do2mad/messsystem-1mhz/hardware/kicad/messystem.kicad_pcb

## KiCad design hardware/kicad/messystem.kicad_pcb (2026-10-09)

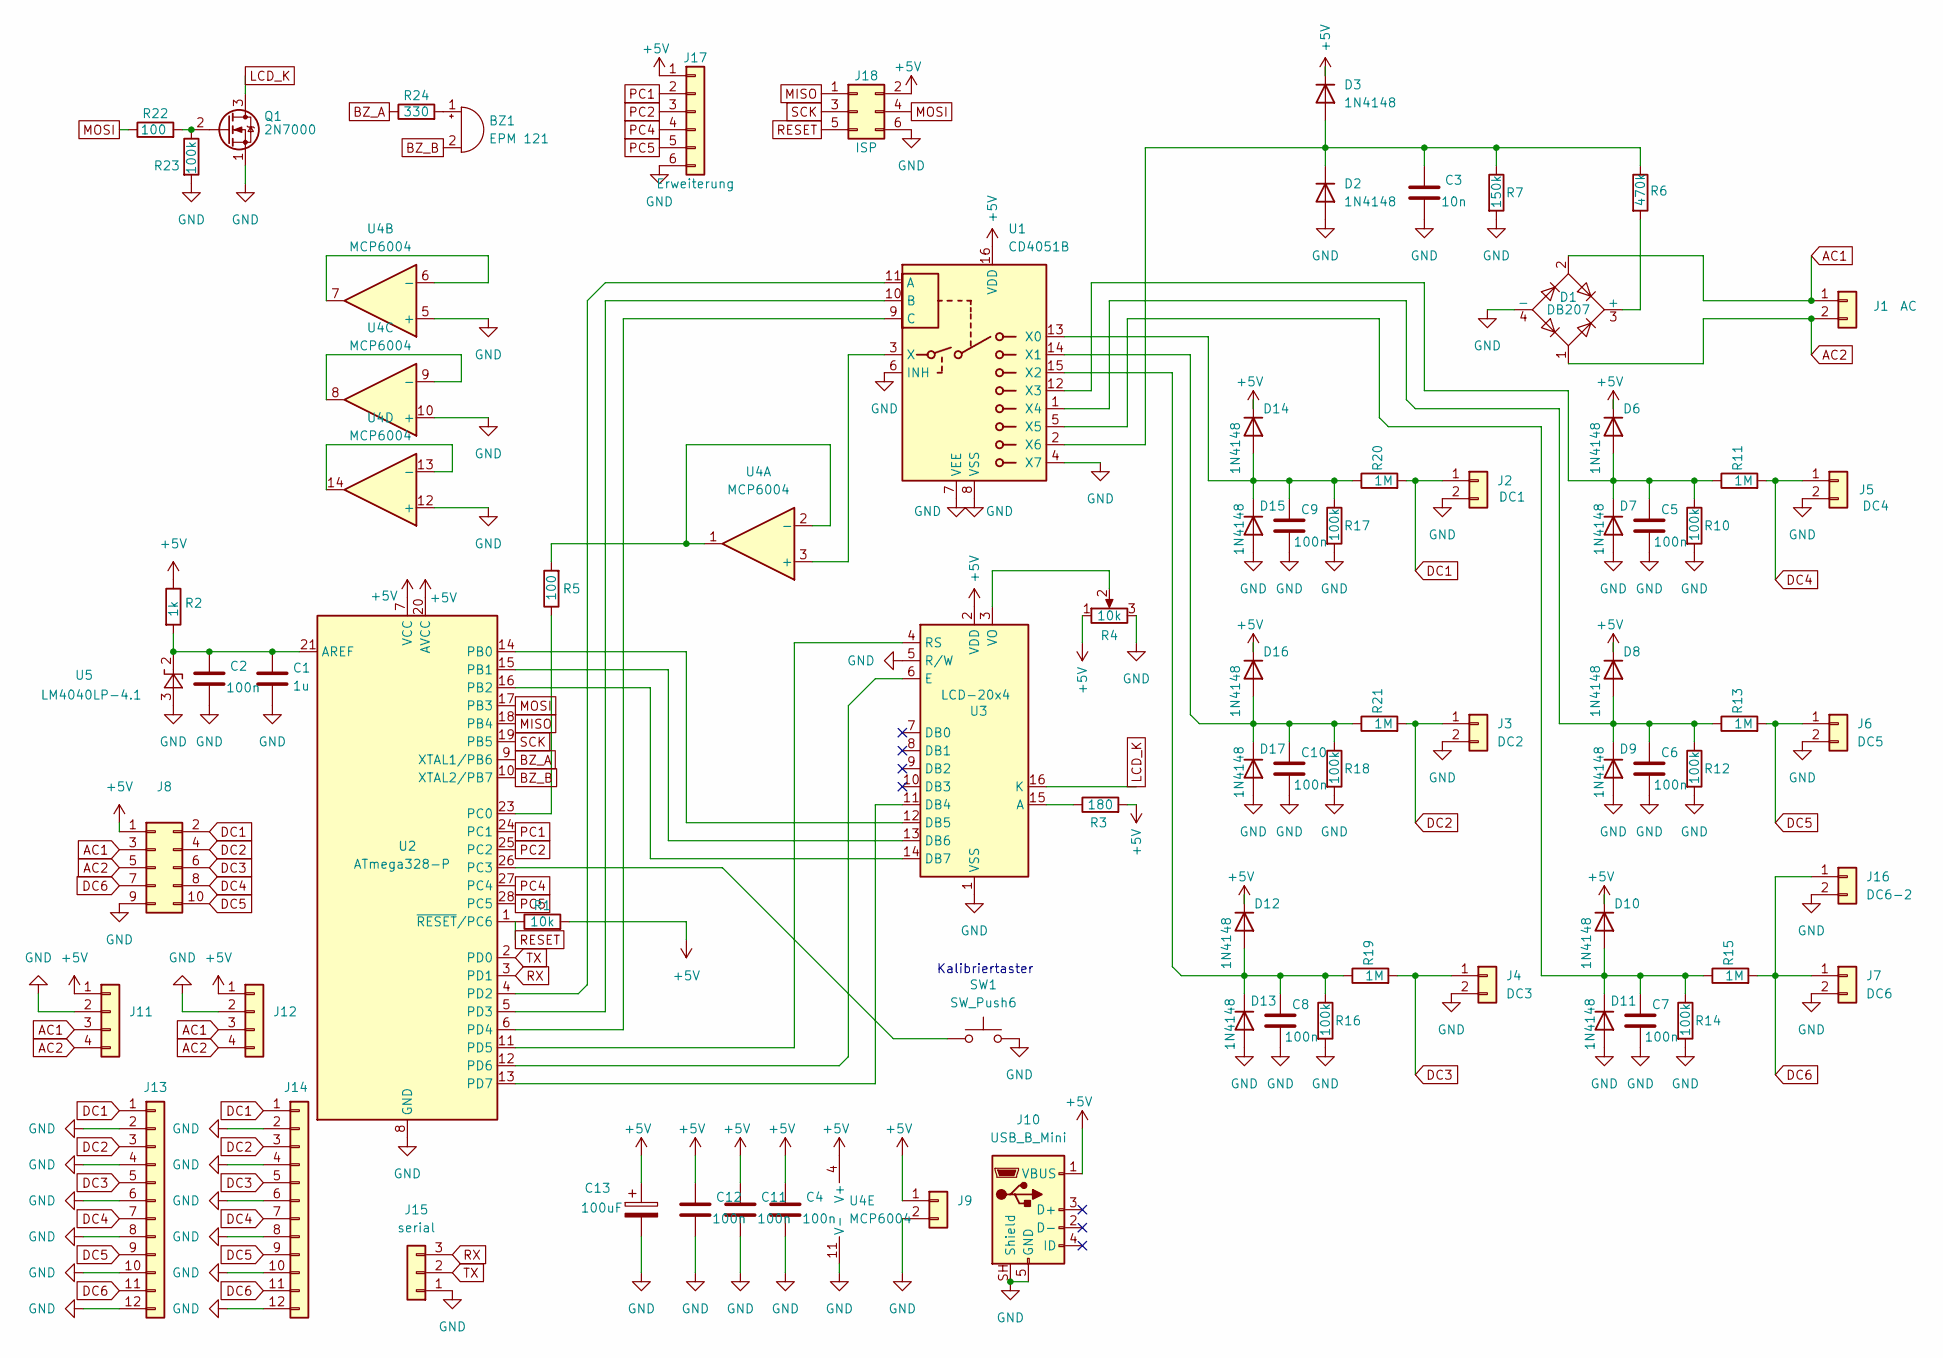
[picture p3: schematic messystem.kicad_sch]

Parts:
BZ1: EPM 121; Buzzer_12x9.5RM7.6
C1: 1u; C_MAD
C2, C4, C5, C6, C7, C8, C9, C10, C11, C12: 100n; C_MAD
C3: 10n; C_MAD
C13: 100uF; Elko_Mad
D1: DB207; Diode_Bridge_DIP-4_W7.62mm_P5.08mm
D2, D3, D6, D7, D8, D9, D10, D11, D12, D13, D14, D15, D16, D17: 1N4148; D_DO-35_SOD27_P7.62mm_Horizontal
J1: AC; PinHeader_1x02_P2.54mm_Vertical-MAD
J2: DC1; PinHeader_1x02_P2.54mm_Vertical-MAD
J3: DC2; PinHeader_1x02_P2.54mm_Vertical-MAD
J4: DC3; PinHeader_1x02_P2.54mm_Vertical-MAD
J5: DC4; PinHeader_1x02_P2.54mm_Vertical-MAD
J6: DC5; PinHeader_1x02_P2.54mm_Vertical-MAD
J7: DC6; PinHeader_1x02_P2.54mm_Vertical-MAD
J8: Conn_02x05_Odd_Even; IDC-Header_2x05_P2.54mm_Horizontal
J9: 5V; PinHeader_1x02_P2.54mm_Vertical-MAD
J10: USB_B_Mini; USB_Mini-B_horizontal
J11, J12: 5V/AC; PinSocket_1x04_P2.54mm_Vertical
J13, J14: DC1-DC6; PinSocket_1x12_P2.54mm_Vertical
J15: serial; PinSocket_1x03_P2.54mm_Vertical
J16: DC6-2; 2mm-banane
J17: Erweiterung; PinHeader_1x06_P2.54mm_Vertical
J18: ISP; PinHeader_2x03_P2.54mm_Vertical
Q1: 2N7000; TO-92_Inline
R1: 10k; R_Axial_DIN0204_L3.6mm_D1.6mm_P7.62mm_Horizontal
R2: 1k; R_Axial_DIN0204_L3.6mm_D1.6mm_P7.62mm_Horizontal
R3: 180; R_Axial_DIN0204_L3.6mm_D1.6mm_P7.62mm_Horizontal
R4: 10k; Potentiometer_Bourns_3296W_Vertical
R5, R22: 100; R_Axial_DIN0204_L3.6mm_D1.6mm_P7.62mm_Horizontal
R6: 470k; R_Axial_DIN0204_L3.6mm_D1.6mm_P7.62mm_Horizontal
R7: 150k; R_Axial_DIN0204_L3.6mm_D1.6mm_P7.62mm_Horizontal
R10, R12, R14, R16, R17, R18, R23: 100k; R_Axial_DIN0204_L3.6mm_D1.6mm_P7.62mm_Horizontal
R11, R13, R15, R19, R20, R21: 1M; R_Axial_DIN0204_L3.6mm_D1.6mm_P7.62mm_Horizontal
R24: 330; R_Axial_DIN0204_L3.6mm_D1.6mm_P7.62mm_Horizontal
SW1: SW_Push6; SW_Tactile_SPST_Angled_PTS645Vx39-2LFS
U1: CD4051B; DIP-16_W7.62mm_Socket_LongPads
U2: ATmega328-P; DIP-28_W7.62mm
U3: LCD-20x4
U4: MCP6004; DIP-14_W7.62mm_LongPads
U5: LM4040LP-4.1; TO-92_Inline

Connections:
+5V: C4.1, C11.1, C12.1, C13.1, D3.1 (K), D6.1 (K), D8.1 (K), D10.1 (K), D12.1 (K), D14.1 (K), D16.1 (K), J8.1, J9.1, J10.1 (VBUS), J11.1, J12.1, J17.1, J18.2, R1.2, R2.1, R3.2, R4.1, U1.16 (VDD), U2.7 (VCC), U2.20 (AVCC), U3.2 (VDD), U4.4 (V+)
AC1: D1.2, J1.1, J8.3, J11.3, J12.3
AC2: D1.1, J1.2, J8.5, J11.4, J12.4
BZ_A: R24.1, U2.9 (XTAL1/PB6)
BZ_B: BZ1.2 (-), U2.10 (XTAL2/PB7)
DC1: J2.1, J8.2, J13.1, J14.1, R20.2
DC2: J3.1, J8.4, J13.3, J14.3, R21.2
DC3: J4.1, J8.6, J13.5, J14.5, R19.2
DC4: J5.1, J8.8, J13.7, J14.7, R11.2
DC5: J6.1, J8.10, J13.9, J14.9, R13.2
DC6: J7.1, J8.7, J13.11, J14.11, J16.1, R15.2
GND: C1.2, C2.2, C3.2, C4.2, C5.2, C6.2, C7.2, C8.2, C9.2, C10.2, C11.2, C12.2, C13.2, D1.4 (-), D2.2 (A), D7.2 (A), D9.2 (A), D11.2 (A), D13.2 (A), D15.2 (A), D17.2 (A), J2.2, J3.2, J4.2, J5.2, J6.2, J7.2, J8.9, J9.2, J10.5 (GND), J10.SH (Shield), J11.2, J12.2, J13.2, J13.4, J13.6, J13.8, J13.10, J13.12, J14.2, J14.4, J14.6, J14.8, J14.10, J14.12, J15.1, J16.2, J17.6, J18.6, Q1.1 (S), R4.3, R7.2, R10.2, R12.2, R14.2, R16.2, R17.2, R18.2, R23.2, SW1.2, U1.4 (X7), U1.6 (INH), U1.7 (VEE), U1.8 (VSS), U2.8 (GND), U2.22 (GND), U3.1 (VSS), U3.5 (R/W), U3.17, U3.18, U3.19, U3.20, U4.5 (+), U4.10 (+), U4.11 (V-), U4.12 (+), U5.3 (A)
LCD_K: Q1.3 (D), U3.16 (K)
MISO: J18.1, U2.18 (PB4)
MOSI: J18.4, R22.1, U2.17 (PB3)
unnamed: BZ1.1 (+), R24.2
unnamed: D1.3 (+), R6.2
unnamed: C3.1, D2.1 (K), D3.2 (A), R6.1, R7.1, U1.2 (X6)
unnamed: C5.1, D6.2 (A), D7.1 (K), R10.1, R11.1, U1.12 (X3)
unnamed: C6.1, D8.2 (A), D9.1 (K), R12.1, R13.1, U1.1 (X4)
unnamed: C7.1, D10.2 (A), D11.1 (K), R14.1, R15.1, U1.5 (X5)
unnamed: C8.1, D12.2 (A), D13.1 (K), R16.1, R19.1, U1.15 (X2)
unnamed: C9.1, D14.2 (A), D15.1 (K), R17.1, R20.1, U1.13 (X0)
unnamed: C10.1, D16.2 (A), D17.1 (K), R18.1, R21.1, U1.14 (X1)
unnamed: Q1.2 (G), R22.2, R23.1
unnamed: U1.11 (A), U2.4 (PD2)
unnamed: U1.10 (B), U2.5 (PD3)
unnamed: U1.9 (C), U2.6 (PD4)
unnamed: U1.3 (X), U4.3 (+)
unnamed: C1.1, C2.1, R2.2, U2.21 (AREF), U5.2 (K)
unnamed: U2.14 (PB0), U3.12 (DB5)
unnamed: U2.15 (PB1), U3.13 (DB6)
unnamed: U2.16 (PB2), U3.14 (DB7)
unnamed: R5.1, U2.23 (PC0)
unnamed: SW1.1, U2.26 (PC3)
unnamed: U2.11 (PD5), U3.4 (RS)
unnamed: U2.12 (PD6), U3.6 (E)
unnamed: U2.13 (PD7), U3.11 (DB4)
unnamed: R3.1, U3.15 (A)
unnamed: R4.2, U3.3 (VO)
unnamed: R5.2, U4.1, U4.2 (-)
unnamed: U4.6 (-), U4.7
unnamed: U4.8, U4.9 (-)
unnamed: U4.13 (-), U4.14
PC1: J17.2, U2.24 (PC1)
PC2: J17.3, U2.25 (PC2)
PC4: J17.4, U2.27 (PC4)
PC5: J17.5, U2.28 (PC5)
RESET: J18.5, R1.1, U2.1 (~RESET/PC6)
RX: J15.3, U2.3 (PD1)
SCK: J18.3, U2.19 (PB5)
TX: J15.2, U2.2 (PD0)

Notes on the sheet:
Kalibriertaster

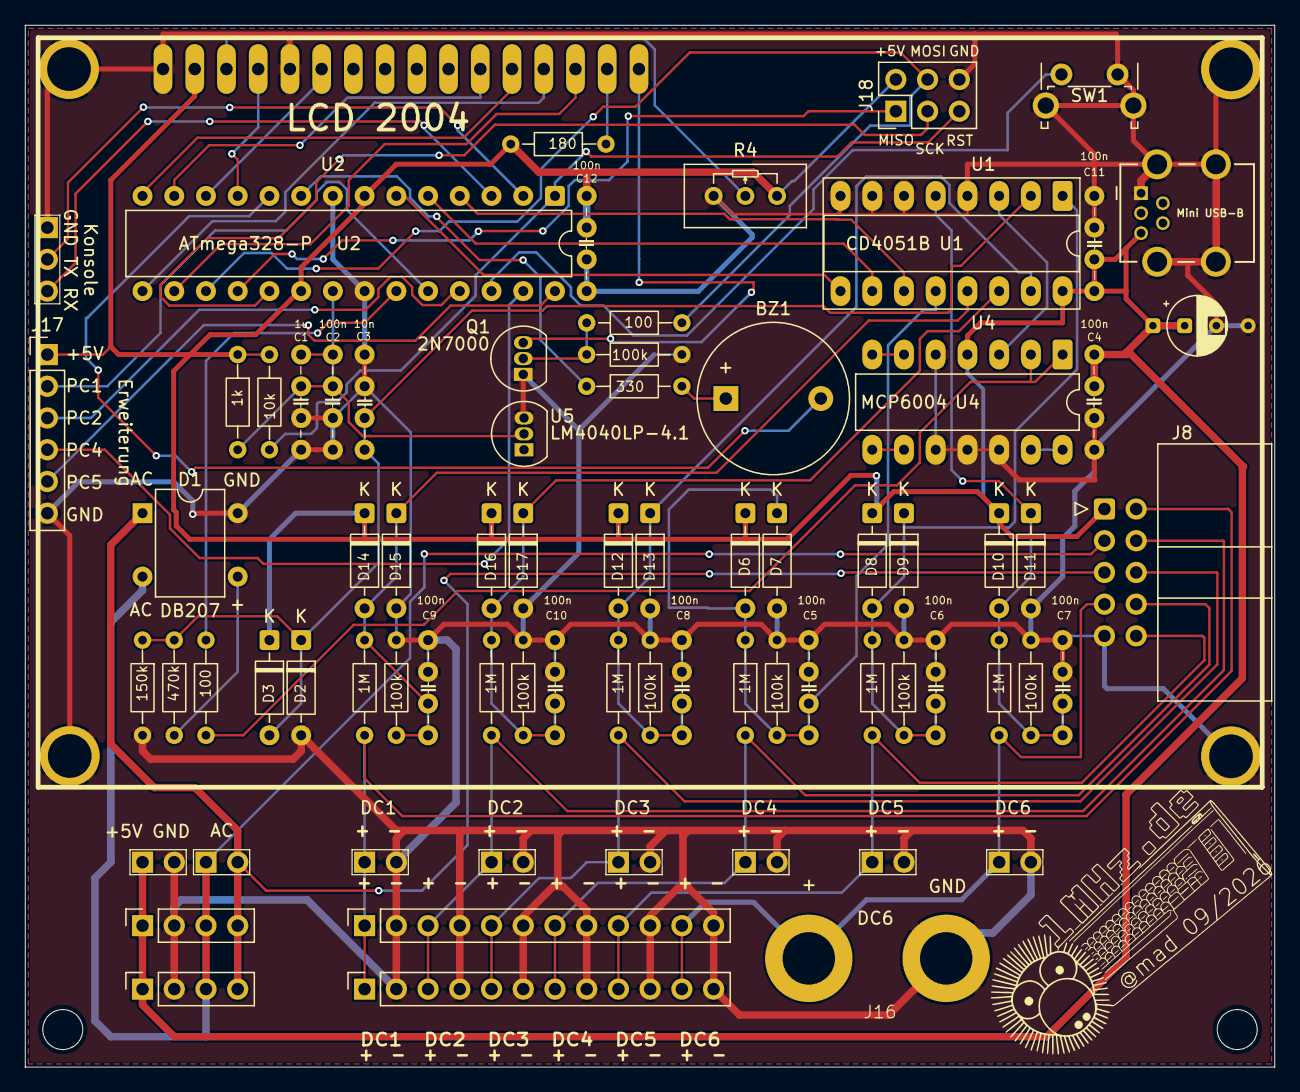
[picture p4: board messystem.kicad_pcb from above]

Board: 2 copper layers, 100.0 x 83.4 mm, 78 parts (1 on the bottom side), 52 nets.

Other parts of the board:
1MHZ, 1MHZ.de: LOGO; 1MHzLogo25
